rockola/T60/T60_Schematic.pdf

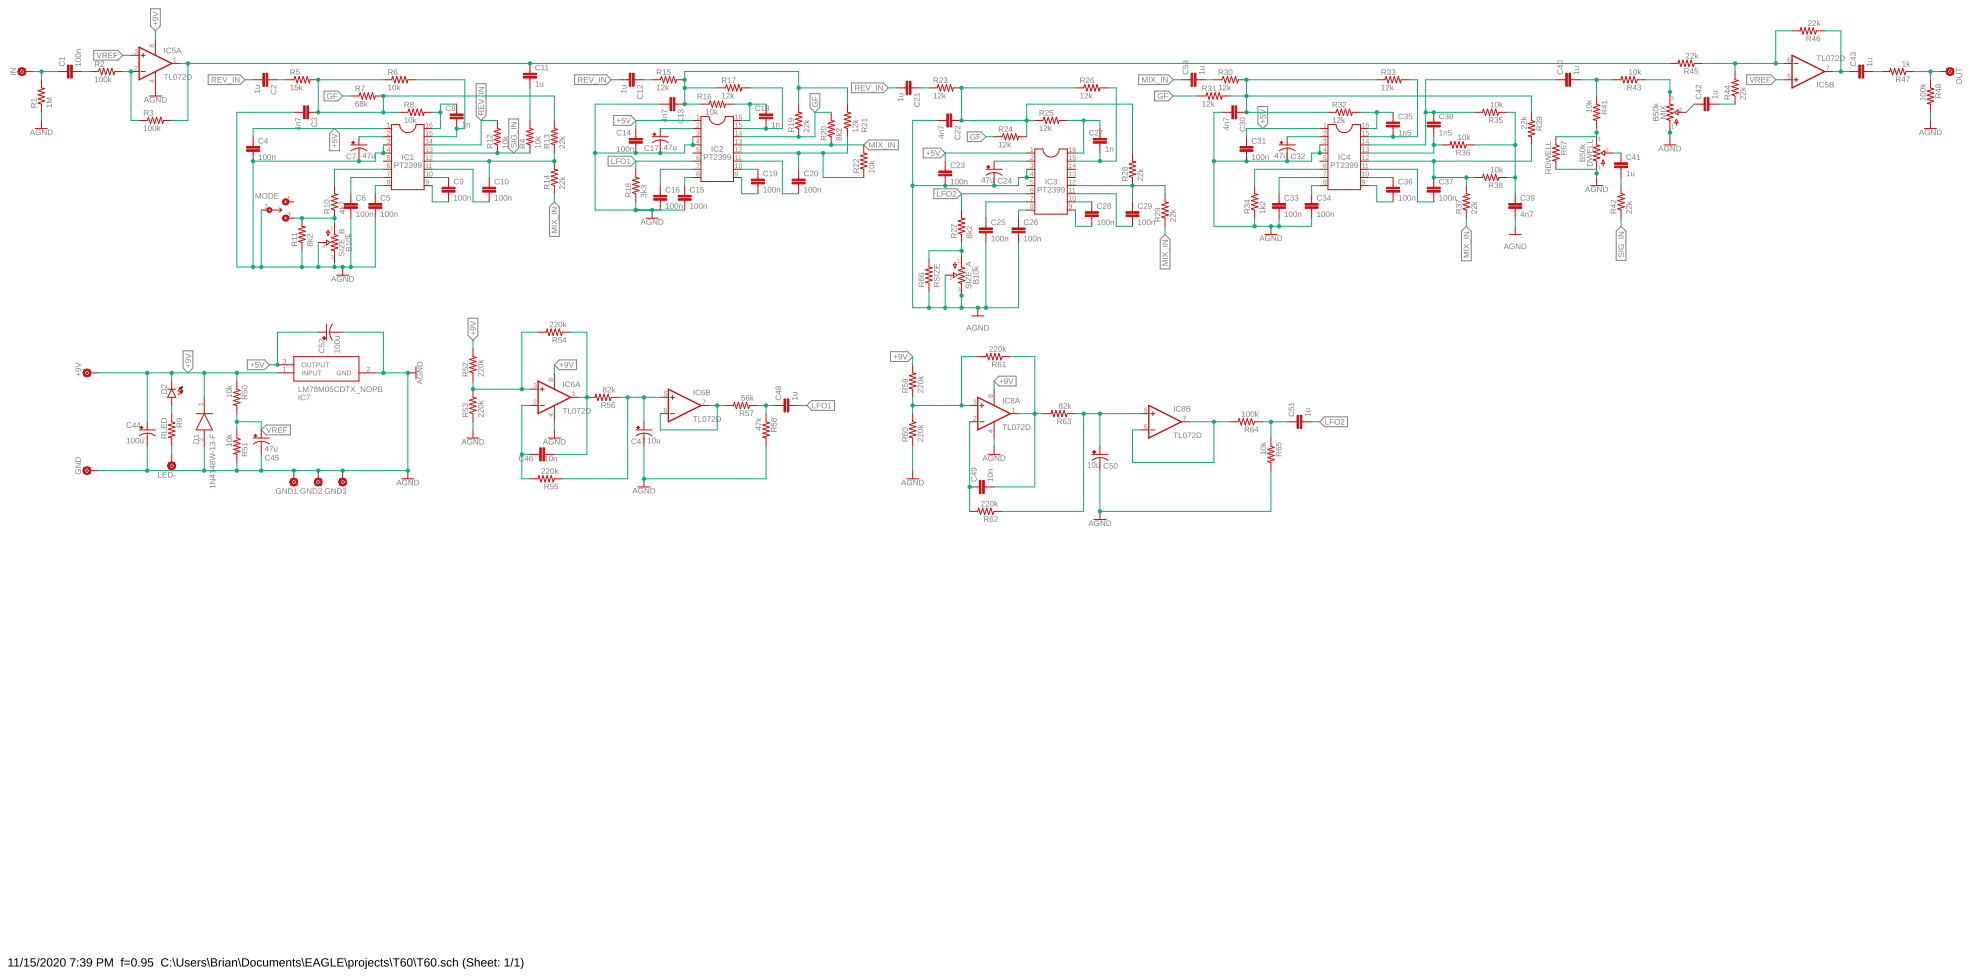
[picture p1: page 1]
